kgarrels/Projects/MCL65+/PCBA/MCL65+.kicad_pcb

## KiCad design MCL65+/PCBA/MCL65+.kicad_pcb (2023-05-14)

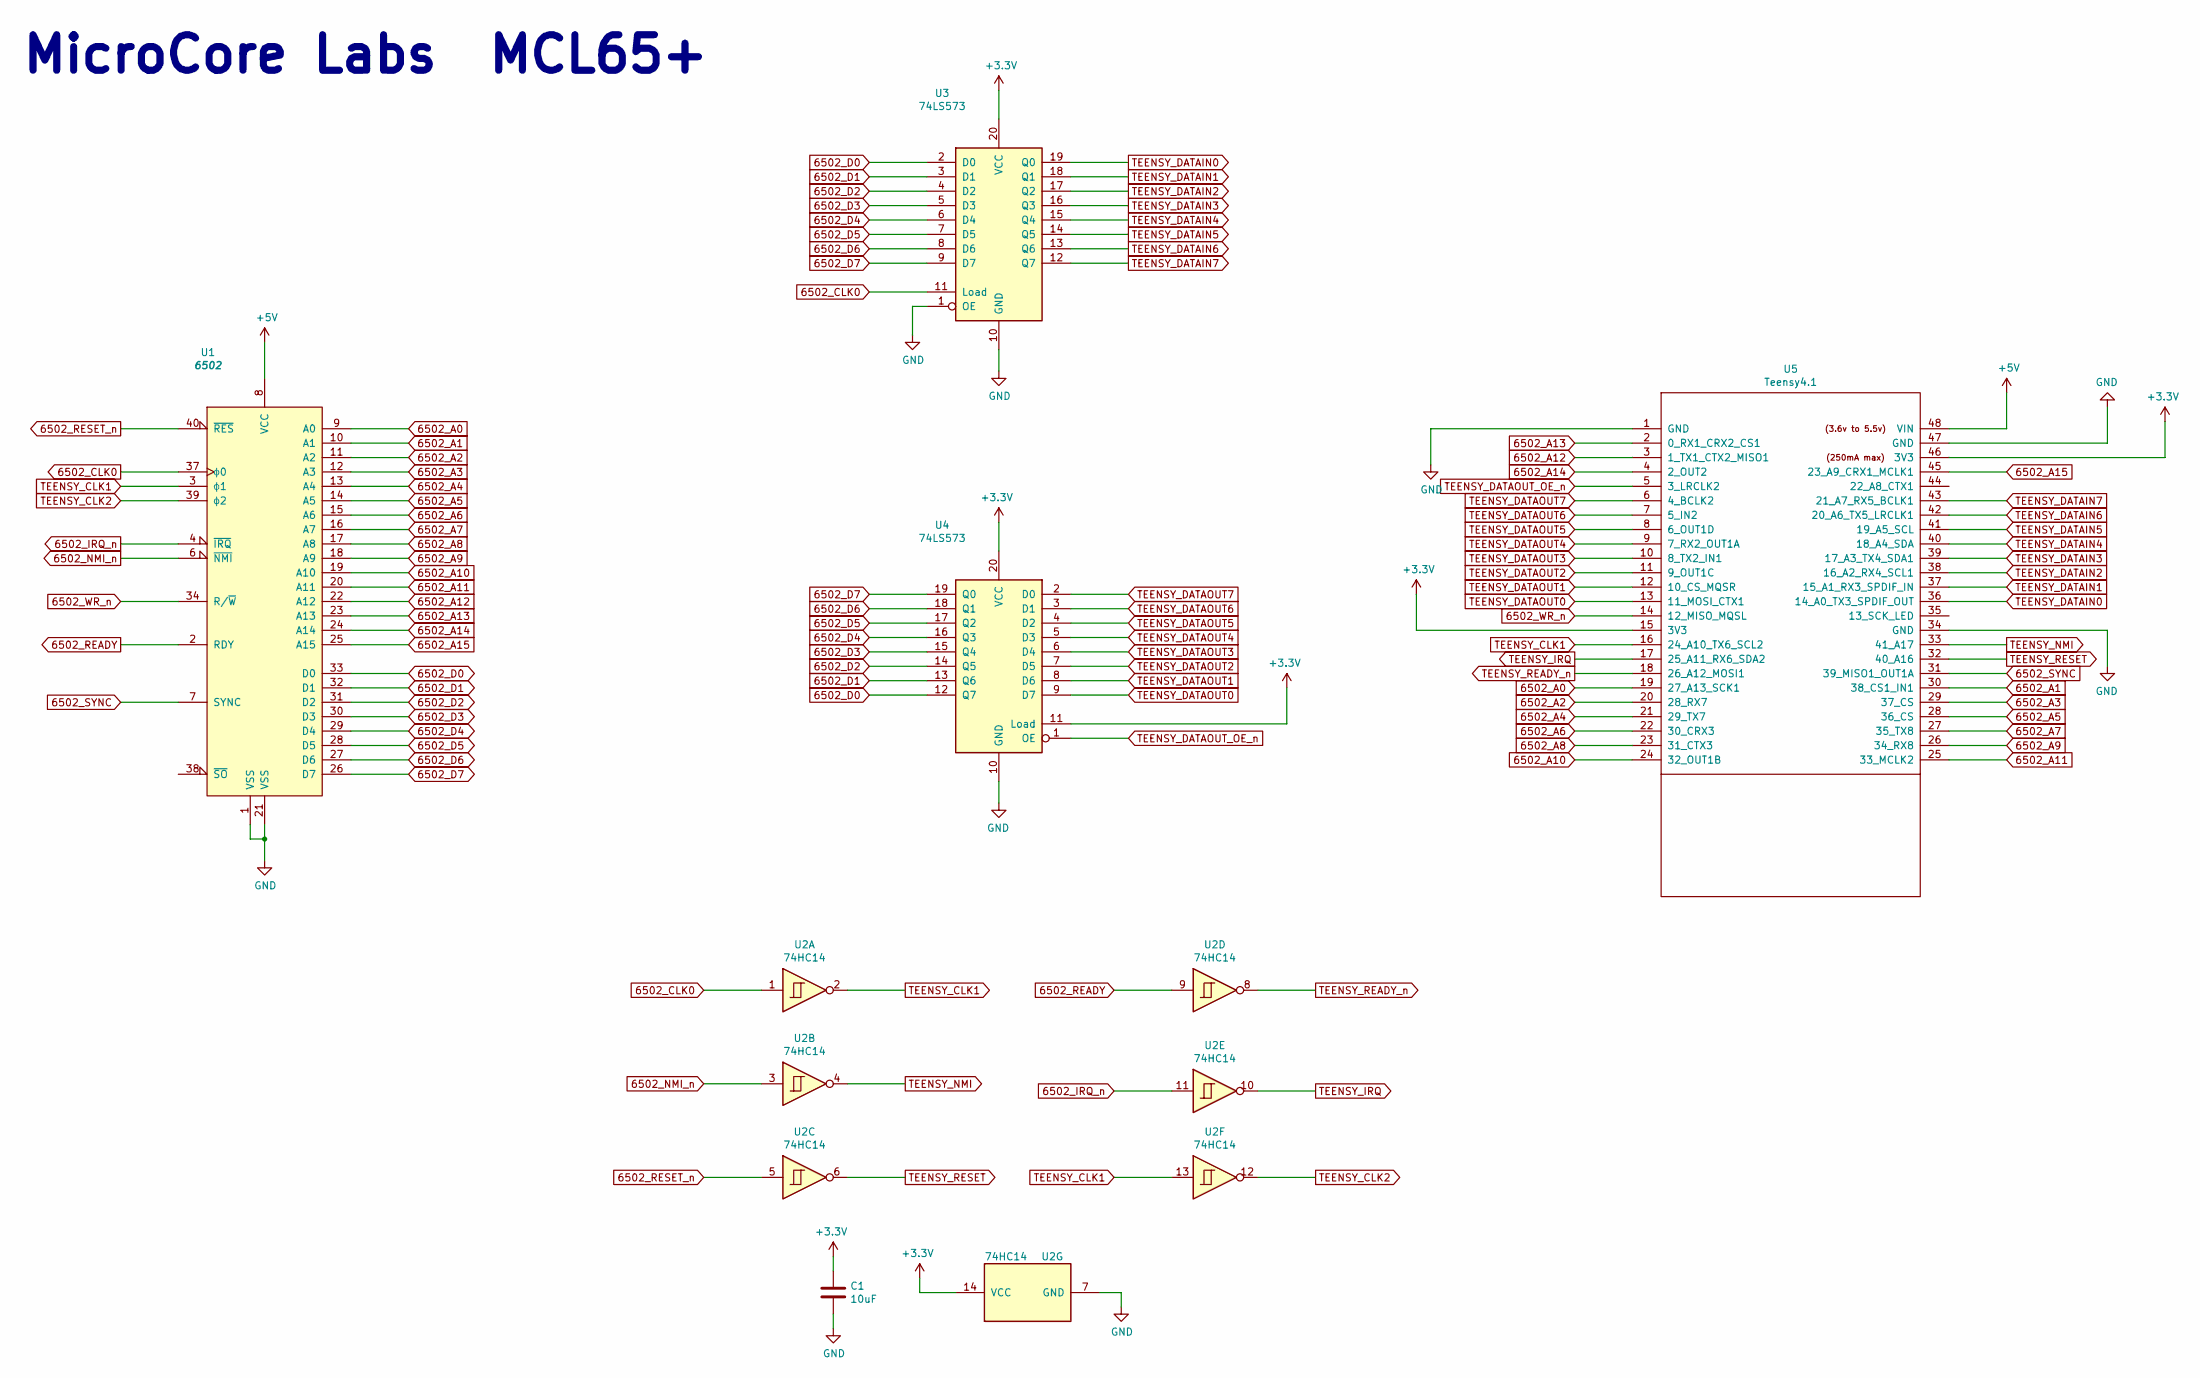
[picture p1: schematic MCL65+.kicad_sch]

Parts:
C1: 10uF; C_Disc_D7.0mm_W2.5mm_P5.00mm
U1: 6502; DIP-40_W15.24mm
U2: 74HC14; DIP-14_W7.62mm_Socket
U3, U4: 74LS573; DIP-20_W7.62mm_Socket
U5: Teensy4.1; Teensy41

Connections:
6502_A0: U1.9 (A0), U5.19 (27_A13_SCK1)
6502_A1: U1.10 (A1), U5.30 (38_CS1_IN1)
6502_A2: U1.11 (A2), U5.20 (28_RX7)
6502_A3: U1.12 (A3), U5.29 (37_CS)
6502_A4: U1.13 (A4), U5.21 (29_TX7)
6502_A5: U1.14 (A5), U5.28 (36_CS)
6502_A6: U1.15 (A6), U5.22 (30_CRX3)
6502_A7: U1.16 (A7), U5.27 (35_TX8)
6502_A8: U1.17 (A8), U5.23 (31_CTX3)
6502_A9: U1.18 (A9), U5.26 (34_RX8)
6502_A10: U1.19 (A10), U5.24 (32_OUT1B)
6502_A11: U1.20 (A11), U5.25 (33_MCLK2)
6502_A12: U1.22 (A12), U5.3 (1_TX1_CTX2_MISO1)
6502_A13: U1.23 (A13), U5.2 (0_RX1_CRX2_CS1)
6502_A14: U1.24 (A14), U5.4 (2_OUT2)
6502_A15: U1.25 (A15), U5.45 (23_A9_CRX1_MCLK1)
6502_CLK0: U1.37 (ϕ0), U2.1, U3.11 (Load)
6502_D0: U1.33 (D0), U3.2 (D0), U4.12 (Q7)
6502_D1: U1.32 (D1), U3.3 (D1), U4.13 (Q6)
6502_D2: U1.31 (D2), U3.4 (D2), U4.14 (Q5)
6502_D3: U1.30 (D3), U3.5 (D3), U4.15 (Q4)
6502_D4: U1.29 (D4), U3.6 (D4), U4.16 (Q3)
6502_D5: U1.28 (D5), U3.7 (D5), U4.17 (Q2)
6502_D6: U1.27 (D6), U3.8 (D6), U4.18 (Q1)
6502_D7: U1.26 (D7), U3.9 (D7), U4.19 (Q0)
6502_IRQ_n: U1.4 (~IRQ), U2.11
6502_NMI_n: U1.6 (~NMI), U2.3
6502_READY: U1.2 (RDY), U2.9
6502_RESET_n: U1.40 (~RES), U2.5
6502_SYNC: U1.7 (SYNC), U5.31 (39_MISO1_OUT1A)
6502_WR_n: U1.34 (R/~W), U5.14 (12_MISO_MQSL)
+3V3: C1.1, U2.14 (VCC), U3.20 (VCC), U4.11 (Load), U4.20 (VCC), U5.15 (3V3), U5.46 (3V3)
+5V: U1.8 (VCC), U5.48 (VIN)
GND: C1.2, U1.1 (VSS), U1.21 (VSS), U2.7 (GND), U3.1 (OE), U3.10 (GND), U4.10 (GND), U5.1 (GND), U5.34 (GND), U5.47 (GND)
TEENSY_CLK1: U1.3 (ϕ1), U2.2, U2.13, U5.16 (24_A10_TX6_SCL2)
TEENSY_CLK2: U1.39 (ϕ2), U2.12
TEENSY_DATAIN0: U3.19 (Q0), U5.36 (14_A0_TX3_SPDIF_OUT)
TEENSY_DATAIN1: U3.18 (Q1), U5.37 (15_A1_RX3_SPDIF_IN)
TEENSY_DATAIN2: U3.17 (Q2), U5.38 (16_A2_RX4_SCL1)
TEENSY_DATAIN3: U3.16 (Q3), U5.39 (17_A3_TX4_SDA1)
TEENSY_DATAIN4: U3.15 (Q4), U5.40 (18_A4_SDA)
TEENSY_DATAIN5: U3.14 (Q5), U5.41 (19_A5_SCL)
TEENSY_DATAIN6: U3.13 (Q6), U5.42 (20_A6_TX5_LRCLK1)
TEENSY_DATAIN7: U3.12 (Q7), U5.43 (21_A7_RX5_BCLK1)
TEENSY_DATAOUT0: U4.9 (D7), U5.13 (11_MOSI_CTX1)
TEENSY_DATAOUT1: U4.8 (D6), U5.12 (10_CS_MQSR)
TEENSY_DATAOUT2: U4.7 (D5), U5.11 (9_OUT1C)
TEENSY_DATAOUT3: U4.6 (D4), U5.10 (8_TX2_IN1)
TEENSY_DATAOUT4: U4.5 (D3), U5.9 (7_RX2_OUT1A)
TEENSY_DATAOUT5: U4.4 (D2), U5.8 (6_OUT1D)
TEENSY_DATAOUT6: U4.3 (D1), U5.7 (5_IN2)
TEENSY_DATAOUT7: U4.2 (D0), U5.6 (4_BCLK2)
TEENSY_DATAOUT_OE_n: U4.1 (OE), U5.5 (3_LRCLK2)
TEENSY_IRQ: U2.10, U5.17 (25_A11_RX6_SDA2)
TEENSY_NMI: U2.4, U5.33 (41_A17)
TEENSY_READY_n: U2.8, U5.18 (26_A12_MOSI1)
TEENSY_RESET: U2.6, U5.32 (40_A16)

Notes on the sheet:
MicroCore Labs MCL65+

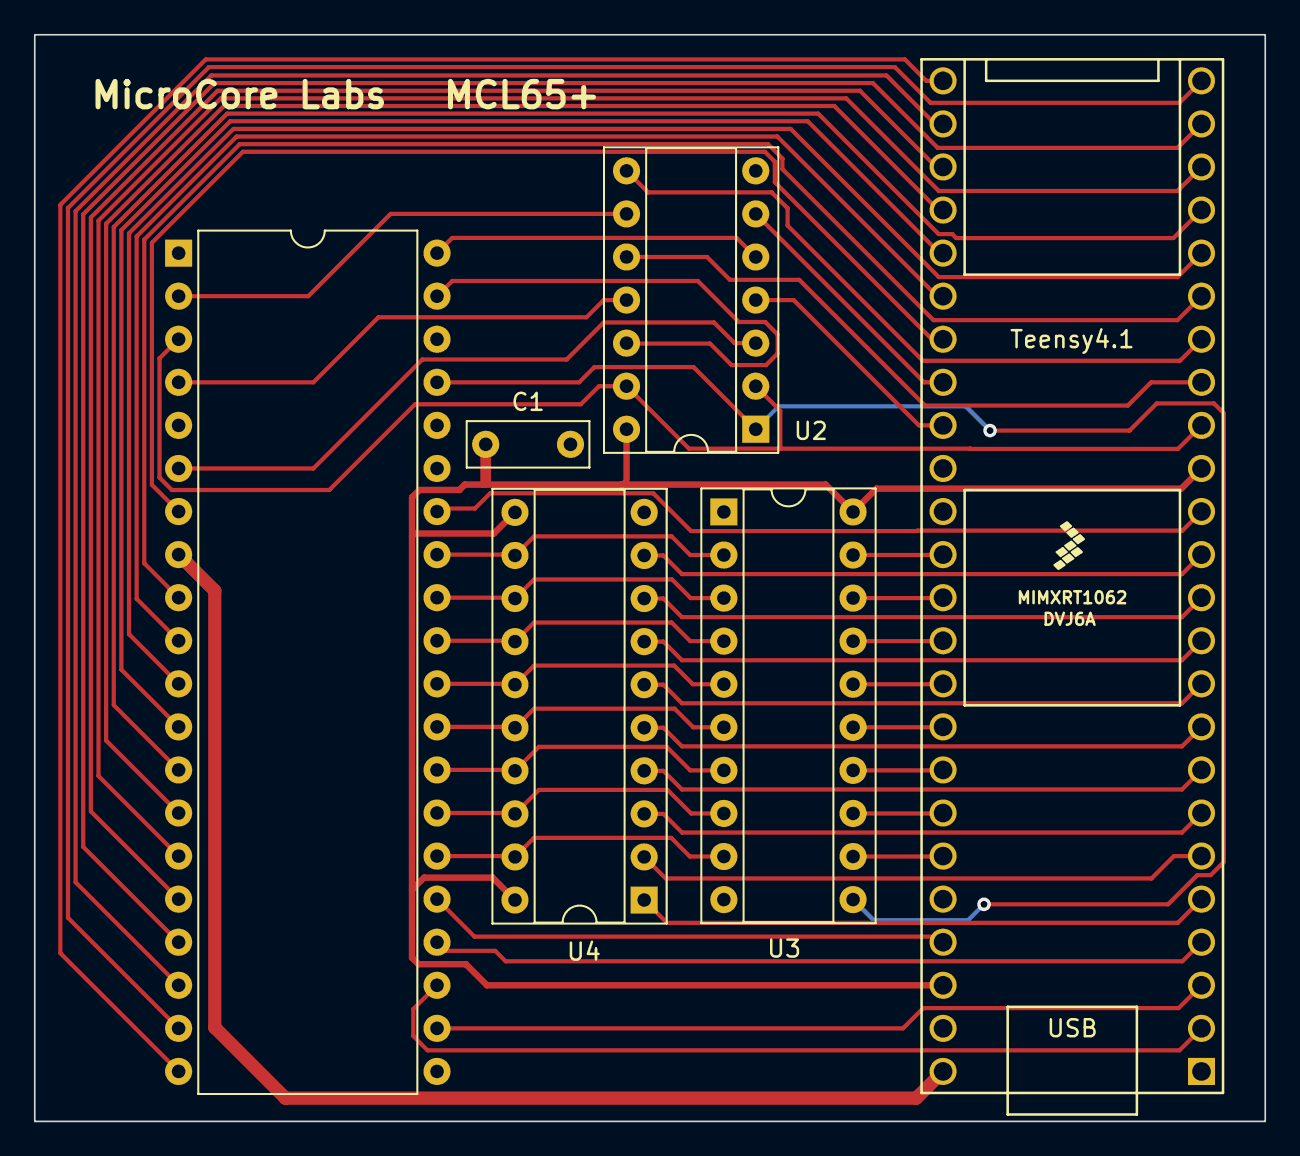
[picture p2: board MCL65+.kicad_pcb from above]

Board: 2 copper layers, 72.6 x 64.1 mm, 6 parts (0 on the bottom side), 57 nets.
